rohit29d/silent-speech-controlled-wheelchair-using-sEMG-signals-from-the-laryngeal-region/hardware/afe/AFE_Breadboard.jpg

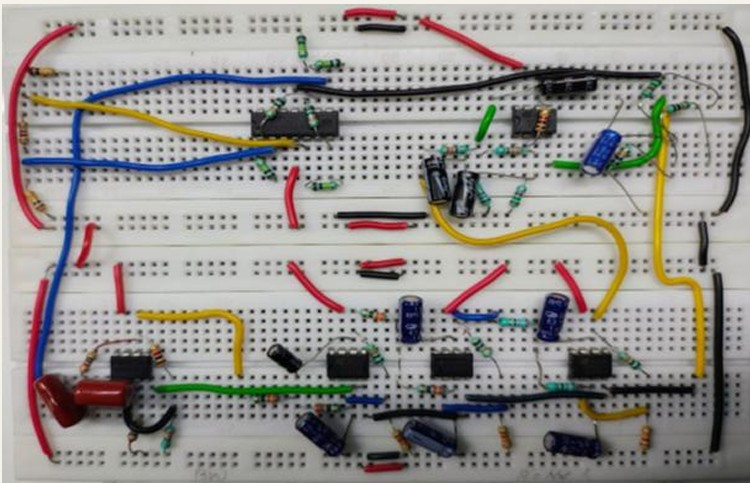
hardware/afe/AFE_Breadboard.jpg
