rohit29d/silent-speech-controlled-wheelchair-using-sEMG-signals-from-the-laryngeal-region/hardware/afe/sEMG_AFE_V2.1.kicad_pro/output/sEMG_AFE_V2.1.kicad_pro_BOM.csv

ITEM_NUMBER | Reference | Value | Footprint | Description | QUANTITY | DNP | MPN | SKU | Link
1 | C1,C2,C3,C4,C5,C6,C7,C8,C9,C10 | 1u | Capacitor_SMD:C_0805_2012Metric | Unpolarized capacitor | 10
2 | C11 | 2.2u | Capacitor_SMD:C_0805_2012Metric | Unpolarized capacitor | 1
3 | C12,C13,C14,C15,C16,C17,C18,C19,C20,C21,C22,C23 | 100nF | Capacitor_SMD:C_0805_2012Metric | Unpolarized capacitor | 12
4 | J1 | Conn_01x03_Pin | Connector_JST:JST_EH_B3B-EH-A_1x03_P2.50mm_Vertical | Generic connector, single row, 01x03, script generated | 1
5 | J2 | Conn_01x01_Pin | Connector_JST:JST_EH_B2B-EH-A_1x02_P2.50mm_Vertical | Generic connector, single row, 01x02, script generated | 1
6 | J3 | Conn_01x04_Pin | TerminalBlock:TerminalBlock_Xinya_XY308-2.54-4P_1x04_P2.54mm_Horizontal | Generic connector, single row, 01x04, script generated | 1
7 | JP1,JP2,JP3 | Jumper_2_Bridged | Connector_PinHeader_2.54mm:PinHeader_1x02_P2.54mm_Vertical | Jumper, 2-pole, closed/bridged | 3
8 | R1,R5,R14,R18,R22 | 10k | Resistor_SMD:R_0805_2012Metric | Resistor | 5
9 | R2,R4,R6,R7 | 100k | Resistor_SMD:R_0805_2012Metric | Resistor | 4
10 | R8,R28 | 1k | Resistor_SMD:R_0805_2012Metric | Resistor | 2
11 | R9,R10 | 6.8k | Resistor_SMD:R_0805_2012Metric | Resistor | 2
12 | R11,R24,R25 | 3.3k | Resistor_SMD:R_0805_2012Metric | Resistor | 3
13 | R12,R13,R16,R17 | 330 | Resistor_SMD:R_0805_2012Metric | Resistor | 4
14 | R15,R19,R23 | 20k | Resistor_SMD:R_0805_2012Metric | Resistor | 3
15 | R20,R21 | 270 | Resistor_SMD:R_0805_2012Metric | Resistor | 2
16 | R26 | 1.2k | Resistor_SMD:R_0805_2012Metric | Resistor | 1
17 | R27 | 1.5k | Resistor_SMD:R_0805_2012Metric | Resistor | 1
18 | Rg1 | R_Potentiometer_Trim | Potentiometer_SMD:Potentiometer_Bourns_3314G_Vertical | Trim-potentiometer | 1
19 | U1,U2,U3,U4,U5 | LM741 | Package_SO:JEITA_SOIC-8_3.9x4.9mm_P1.27mm | Operational Amplifier, DIP-8/TO-99-8 | 5
20 | U6 | LM324NSRE4 | LM324_SMD:SOIC127P780X200-14N |  | 1
