rohit29d/silent-speech-controlled-wheelchair-using-sEMG-signals-from-the-laryngeal-region/hardware/simulations/bessel_bpf_4.pdf

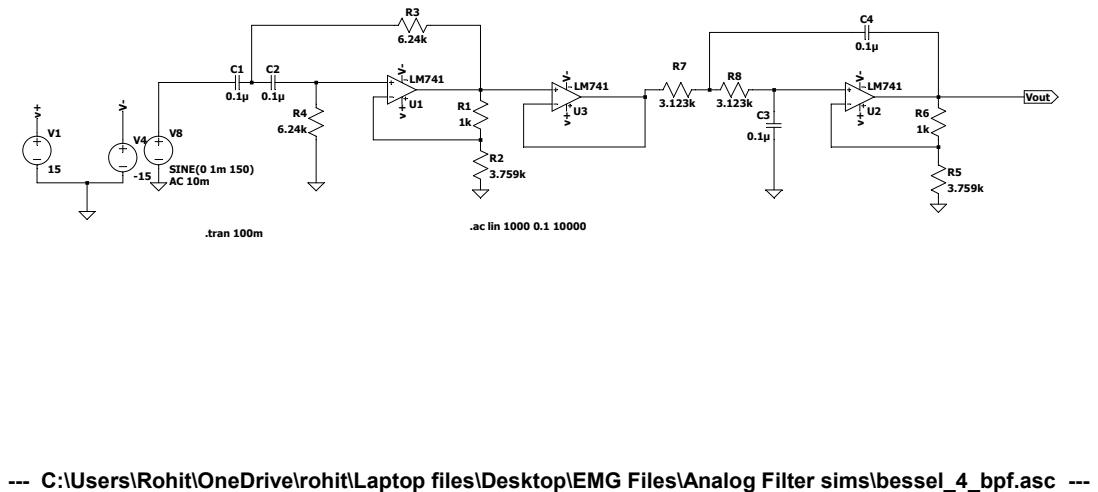
[picture p12: page 1]

--- C:\Users\Rohit\OneDrive\rohit\Laptop files\Desktop\EMG Files\Analog Filter sims\bessel_4_bpf.asc ---
