rohit29d/silent-speech-controlled-wheelchair-using-sEMG-signals-from-the-laryngeal-region/hardware/simulations/bessel_bpf_4_freq_resp.pdf

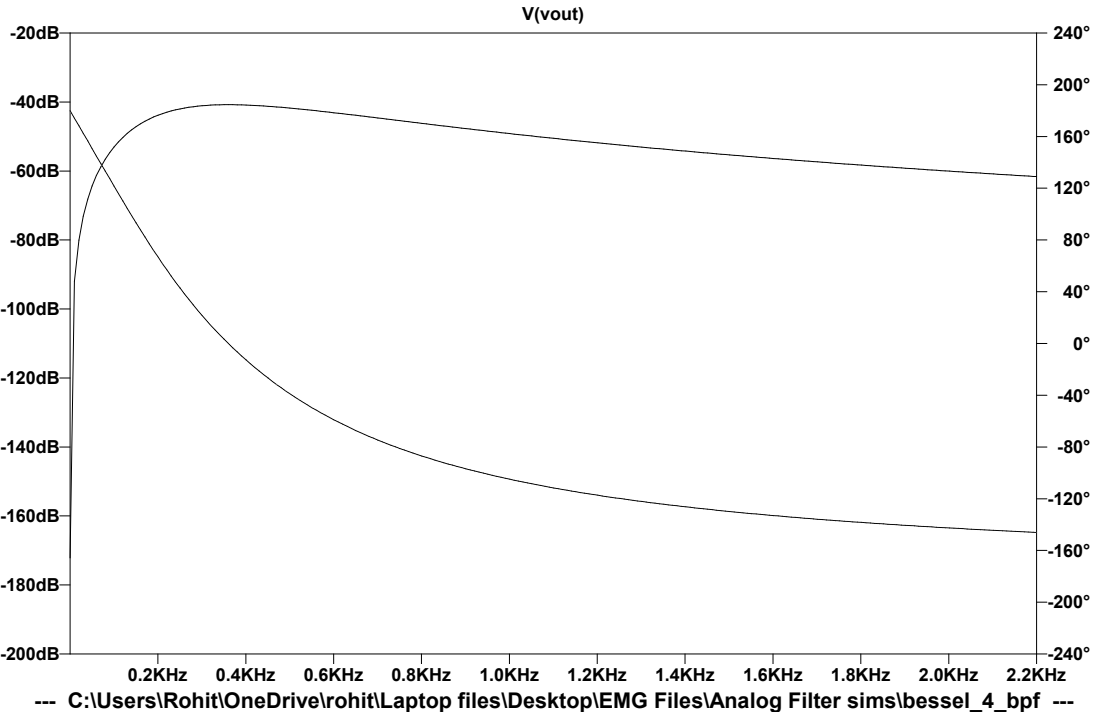
[picture p13: page 1]
0.2KHz; 0.4KHz; 0.6KHz; 0.8KHz; 1.0KHz; 1.2KHz; 1.4KHz; 1.6KHz; 1.8KHz; 2.0KHz; 2.2KHz; V(vout)

--- C:\Users\Rohit\OneDrive\rohit\Laptop files\Desktop\EMG Files\Analog Filter sims\bessel_4_bpf ---
