rohit29d/silent-speech-controlled-wheelchair-using-sEMG-signals-from-the-laryngeal-region/hardware/afe/sEMG_AFE_V2.1.kicad_pro/output/sEMG_AFE_V2.1.kicad_pro_schematic.pdf

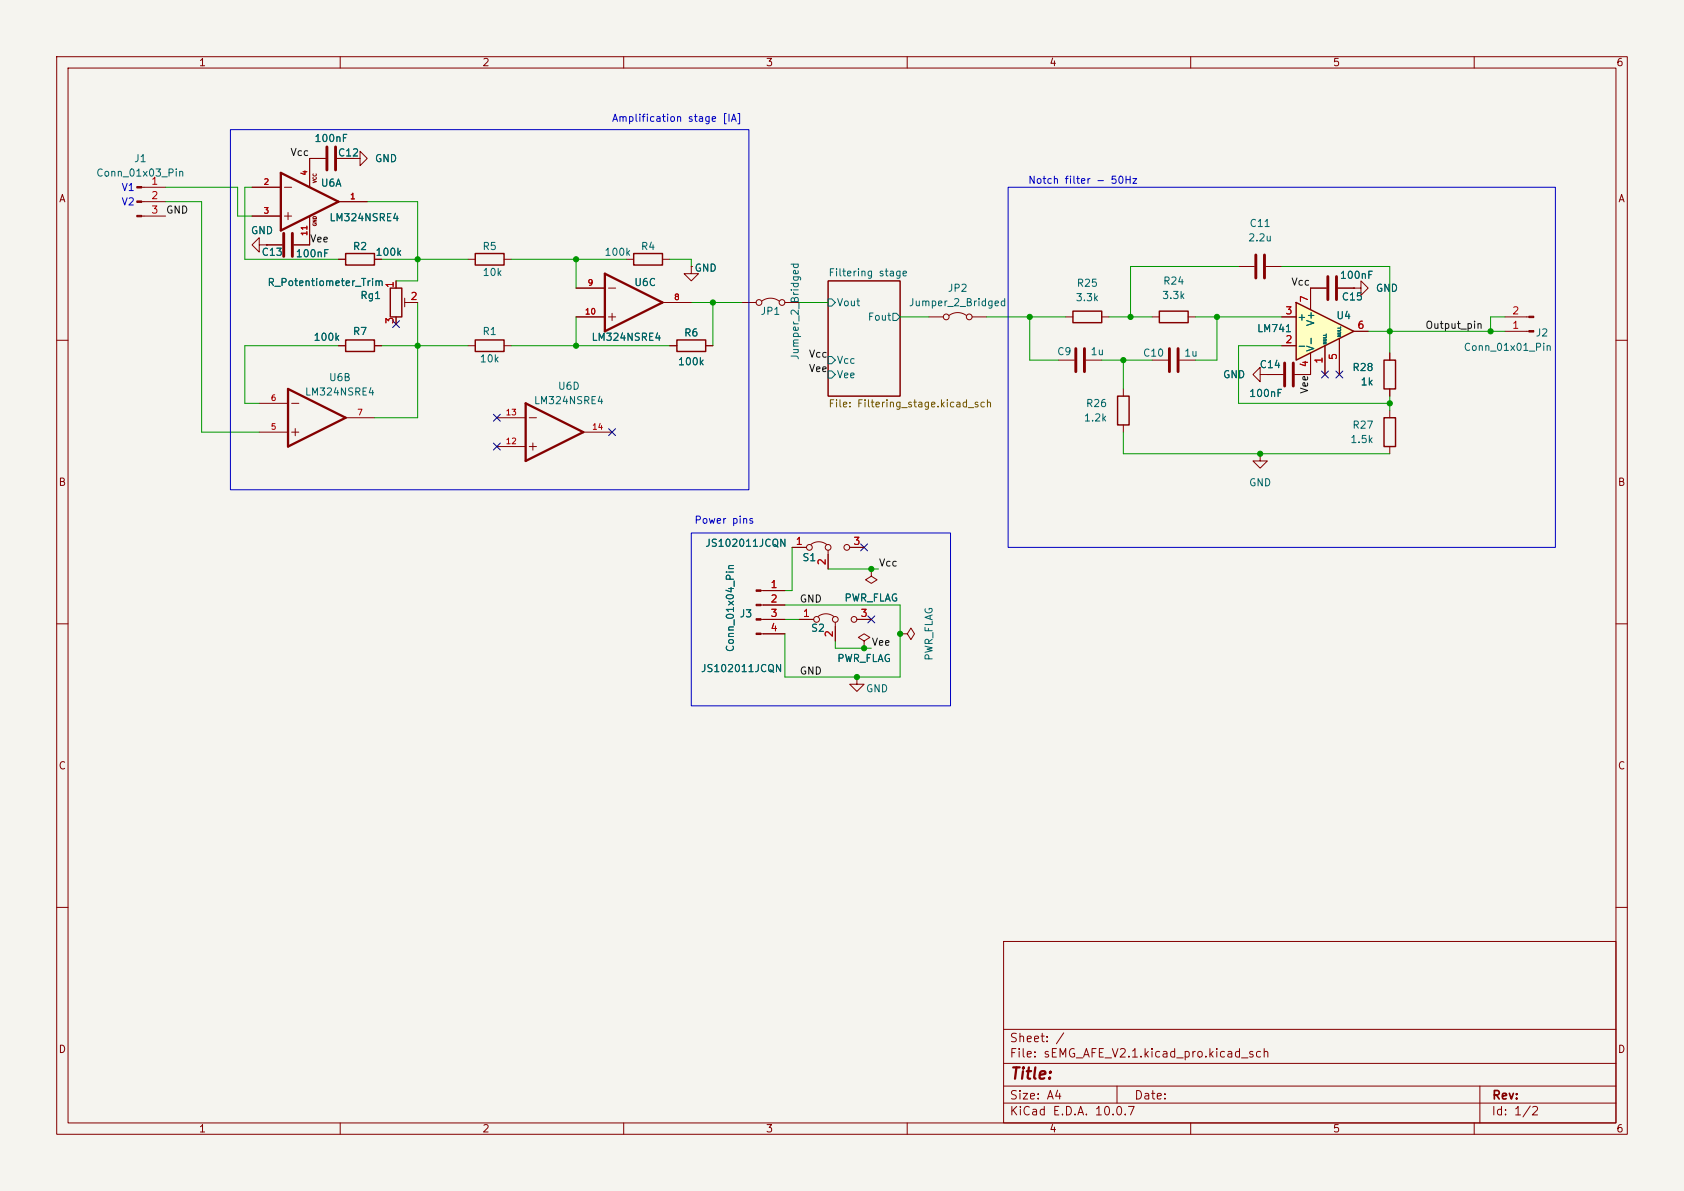
[picture p14: page 1]

Vout Fout Filtering stage

Size: A4 | Rev:
KiCad E.D.A. 10.0.7 | Id: 1/2

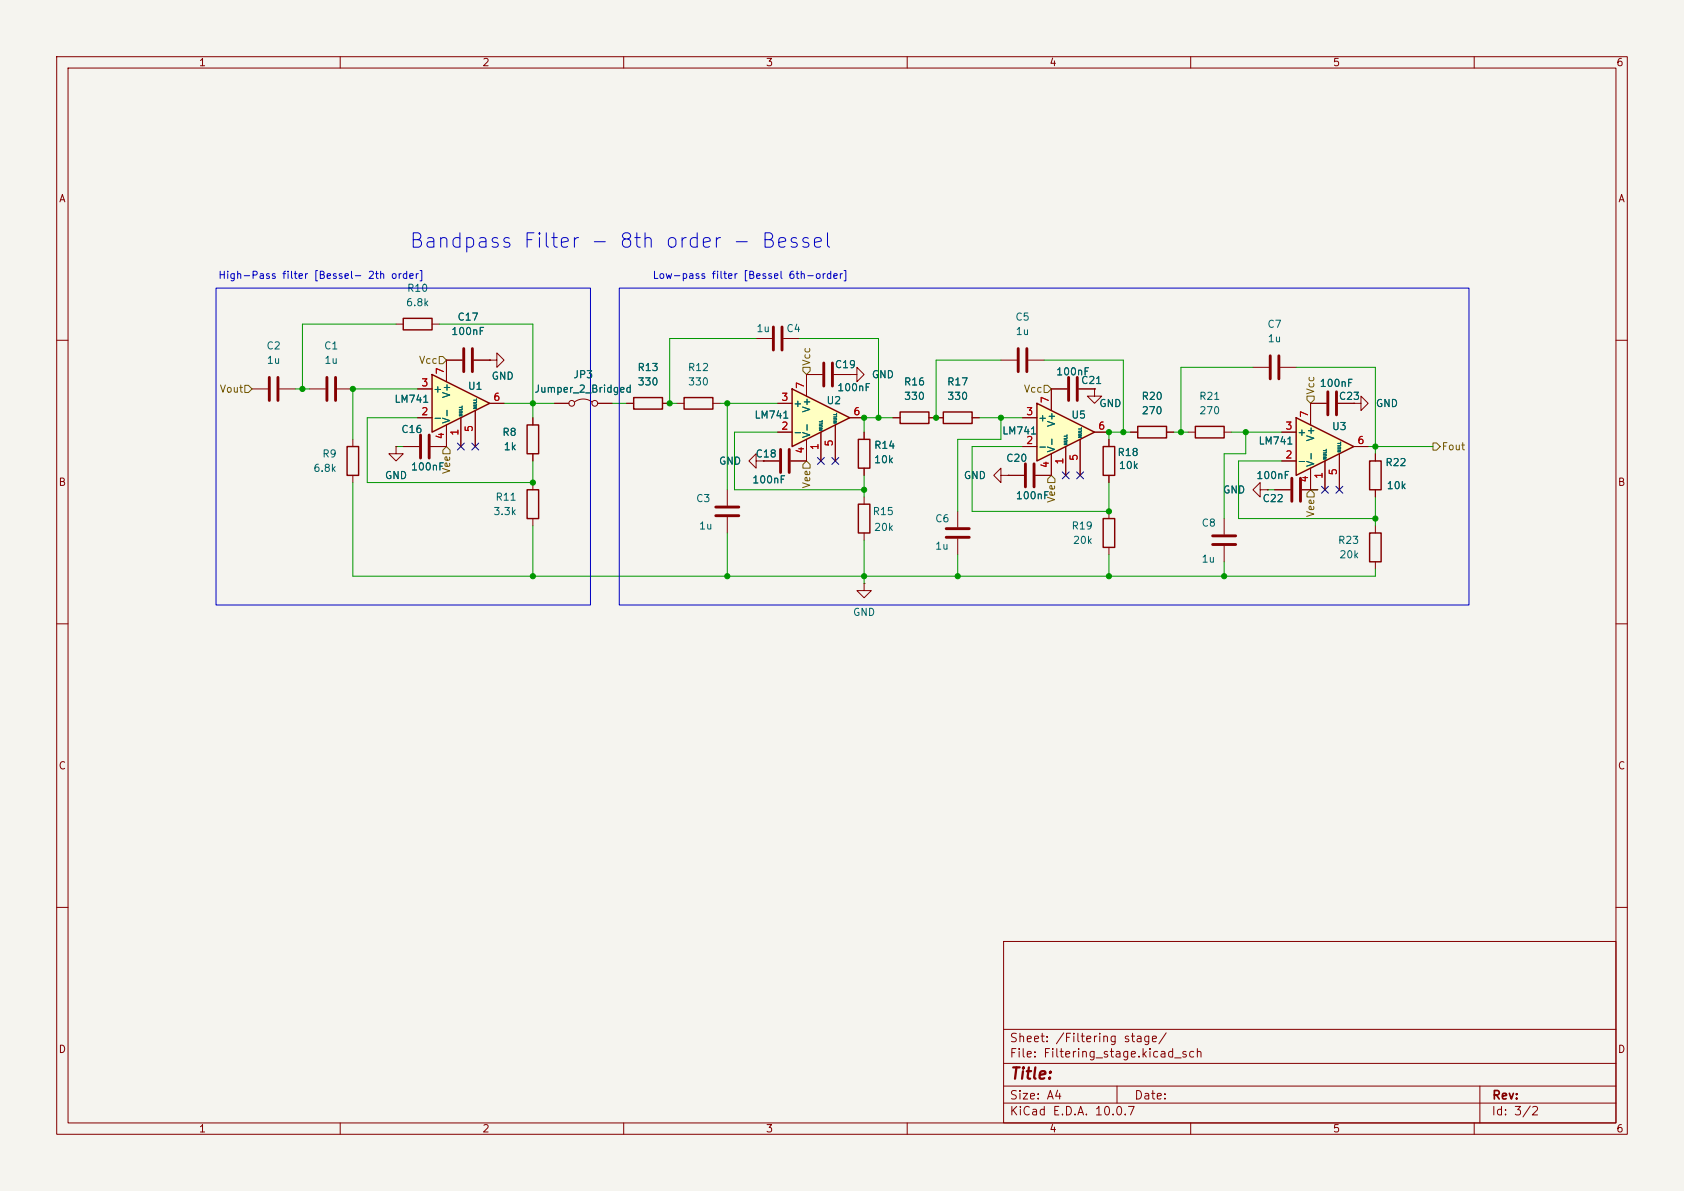
[picture p15: page 2]

Bandpass Filter - 8th order - Bessel

Size: A4 | Rev:
KiCad E.D.A. 10.0.7 | Id: 3/2
