rohit29d/silent-speech-controlled-wheelchair-using-sEMG-signals-from-the-laryngeal-region/hardware/afe/sEMG_AFE_V2.1.kicad_pro/output/sEMG_AFE_V2.1.kicad_pro_Bottom_Assembly.pdf

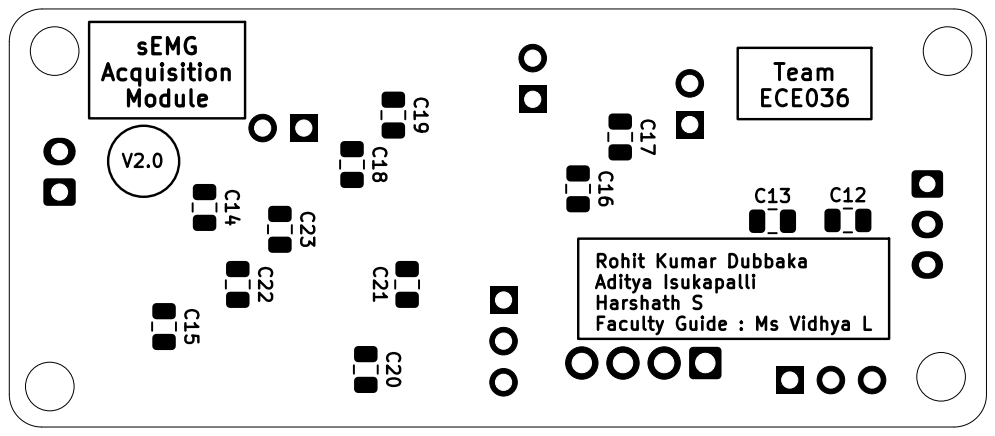
[picture p16: page 1]

Faculty Guide : Ms Vidhya L Team
