rohit29d/silent-speech-controlled-wheelchair-using-sEMG-signals-from-the-laryngeal-region/hardware/afe/sEMG_AFE_V2.1.kicad_pro/output/sEMG_AFE_V2.1.kicad_pro_Top_Assembly.pdf

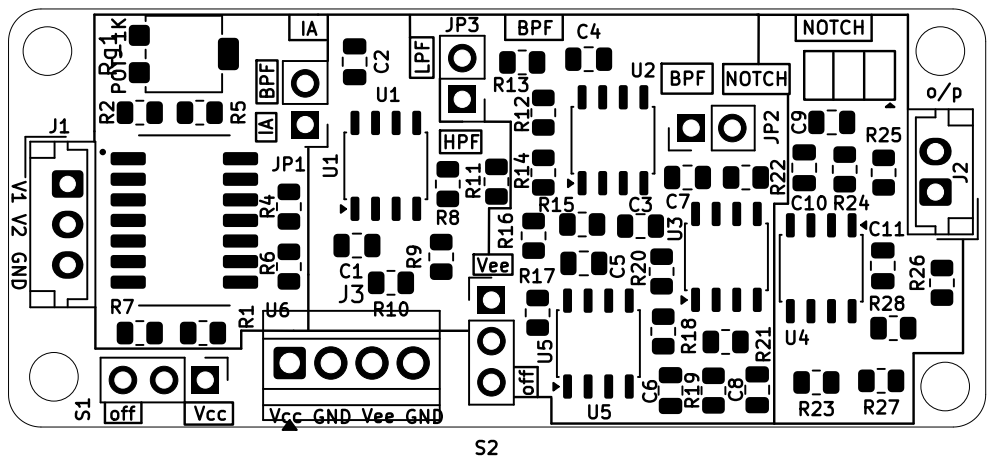
[picture p17: page 1]
