rohit29d/silent-speech-controlled-wheelchair-using-sEMG-signals-from-the-laryngeal-region/hardware/simulations/bessel_final_4th_order_bpf.asc

C1: cap; 0.1µ
C2: cap; 0.1µ
C3: cap; 0.1µ
C4: cap; 0.1µ
R1: res; 62k
R2: res; 1k
R3: res; 3.759k
R4: res; 3.123k
R5: res; 1k
R6: res; 3.759k
R7: res; 3.123k
R10: res; 62k
U1: opamp2; UA741
U2: opamp2; UA741
V1: voltage; 15
V2: voltage; 15
V3: voltage; SINE(0 1m 150); AC AC 1
Named nets: 0, V+, V-, Vin
.include UA741.301
;tran 11s
.ac lin 1000 1 20k
