rohit29d/silent-speech-controlled-wheelchair-using-sEMG-signals-from-the-laryngeal-region/hardware/simulations/Butterworth_filter.asc

C1: cap; 1µ
C2: cap; 1µ
C5: cap; 0.1µ
C6: cap; 0.1µ
R1: res; 0.58k
R2: res; 1k
R3: res; 7.95k
R4: res; 7.95k
R9: res; 0.58k
R10: res; 1k
R11: res; 5.30k
R12: res; 5.30k
U1: opamp2; TL084
U3: opamp2; TL084
V1: voltage; 12
V2: voltage; 12
V7: voltage; 12
V8: voltage; 12
V9: voltage; PWL file="C:\Users\SPR\OneDrive\Pictures\Documents\3rd year (6)\emg_input_ltspice_1.txt"; AC 1
Named nets: 0, Vo
.include "C:\\Users\\SPR\\Downloads\\sloj071\\TL084.301"
.meas RMS_filtered_signal RMS V(Vo) FROM 0 to 10ms
.meas RMS_filtered_signal RMS V(emg_input_ltspice_1) FROM 0 to 10ms
.ac lin 0.01 10 1k
