rohit29d/silent-speech-controlled-wheelchair-using-sEMG-signals-from-the-laryngeal-region/hardware/simulations/intrs_amp.asc

R1: res; 50k
R2: res; 50k
R3: res; 25k
R4: res; 25k
R5: res; 25k
R6: res; 25k
R7: res; 50
R8: res; 100k
R9: res; 10k
R10: res; 100k
U1: LM741
U2: LM741
U3: LM741
V1: voltage; SINE(0 1 150)
V3: voltage; 15
V4: voltage; 15
Named nets: 0, V+, V-, Vout
.tran 100m
