rohit29d/silent-speech-controlled-wheelchair-using-sEMG-signals-from-the-laryngeal-region/hardware/simulations/Notch.asc

C1: cap; 1µ
C2: cap; 1µ
R1: res; 3.2k
R2: res; 3.2k
R3: res; 3.2k
R4: res; 3.2k
U2: LM741
V1: voltage; 15
V2: voltage; 15
V3: voltage; SINE(0 1m 150); AC 1
Named nets: 0, Vo
.tran 0.01
.ac dec 10 1 100
