rohit29d/silent-speech-controlled-wheelchair-using-sEMG-signals-from-the-laryngeal-region/hardware/afe/sEMG_AFE_V2.1.kicad_pro/sEMG_AFE_V2.1.kicad_pro.kicad_pcb

## KiCad design hardware/afe/sEMG_AFE_V2.1.kicad_pro/sEMG_AFE_V2.1.kicad_pro.kicad_pcb (2026-10-13)

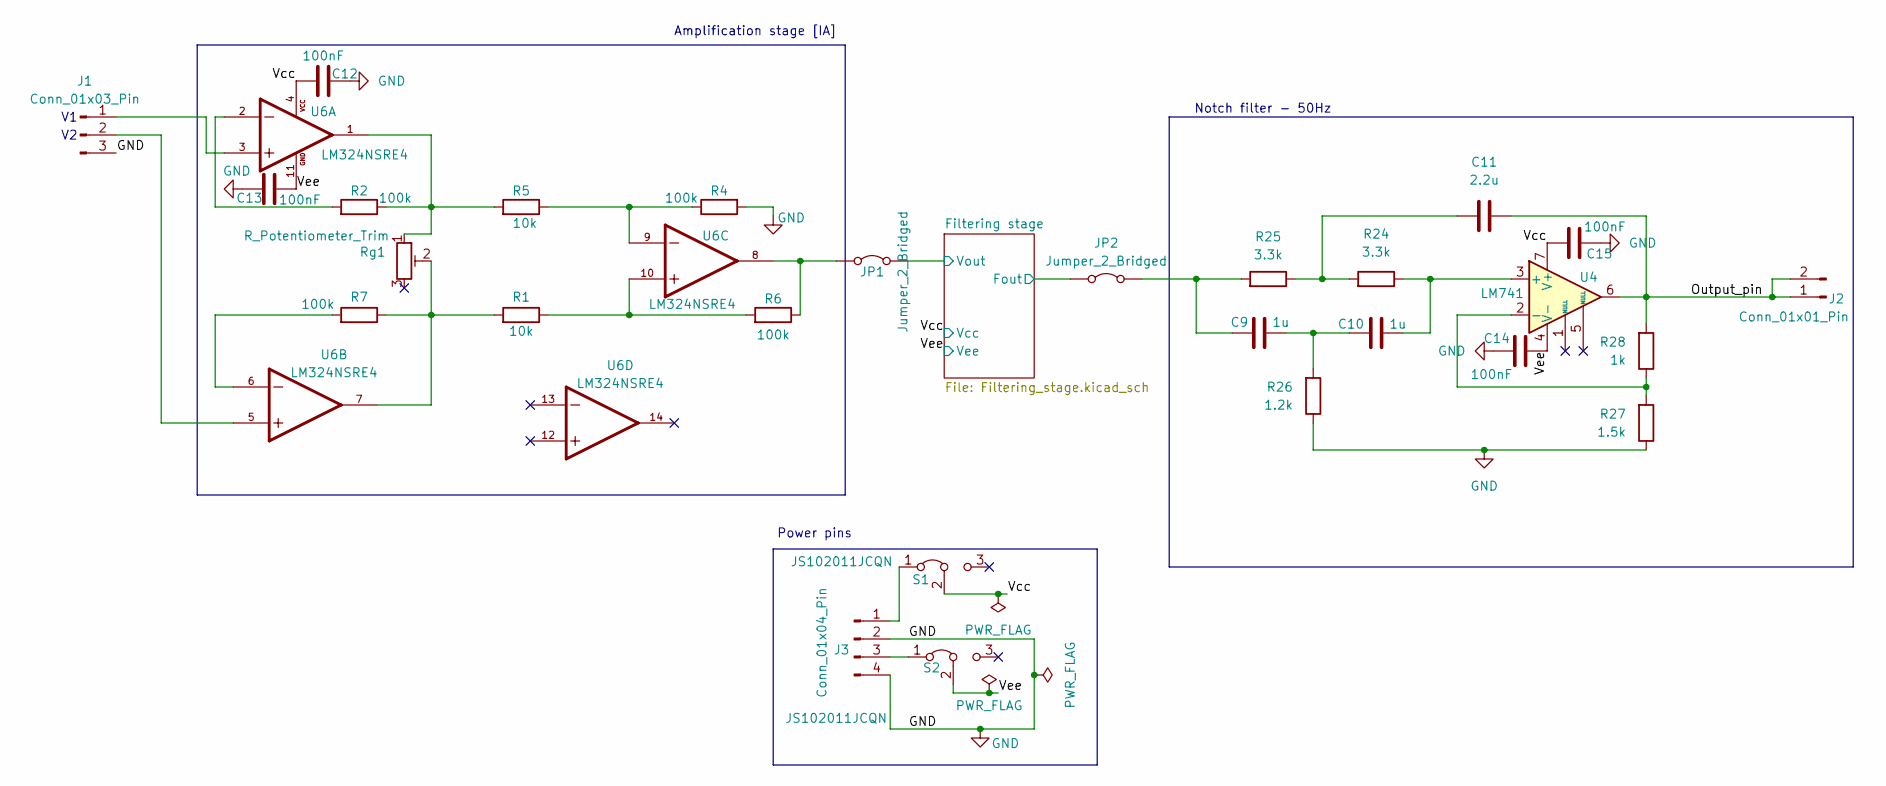
[picture p18: schematic sEMG_AFE_V2.1.kicad_pro.kicad_sch]

Parts:
C9, C10: 1u; C_0805_2012Metric
C11: 2.2u; C_0805_2012Metric
C12, C13, C14, C15: 100nF; C_0805_2012Metric
J1: Conn_01x03_Pin; JST_EH_B3B-EH-A_1x03_P2.50mm_Vertical
J2: Conn_01x01_Pin; JST_EH_B2B-EH-A_1x02_P2.50mm_Vertical
J3: Conn_01x04_Pin; TerminalBlock_Xinya_XY308-2.54-4P_1x04_P2.54mm_Horizontal
JP1, JP2: Jumper_2_Bridged; PinHeader_1x02_P2.54mm_Vertical
R1, R5: 10k; R_0805_2012Metric
R2, R4, R6, R7: 100k; R_0805_2012Metric
R24, R25: 3.3k; R_0805_2012Metric
R26: 1.2k; R_0805_2012Metric
R27: 1.5k; R_0805_2012Metric
R28: 1k; R_0805_2012Metric
Rg1: R_Potentiometer_Trim; Potentiometer_Bourns_3314G_Vertical
S1, S2: JS102011JCQN; PinHeader_1x03_P2.54mm_Vertical; PARTREV 29 JUN 2016
U4: LM741; JEITA_SOIC-8_3.9x4.9mm_P1.27mm
U6: LM324NSRE4; SOIC127P780X200-14N; PARTREV W

Connections:
/Filtering stage/Fout: JP2.1 (A); also elsewhere on the board
/Filtering stage/Vout: JP1.2 (B); also elsewhere on the board
/Output_pin: C11.2, J2.1, J2.2, R28.2, U4.6
/Vcc: C12.1, C15.1, S1.2 (C), U4.7 (V+), U6.4; also elsewhere on the board
/Vee: C13.2, C14.2, S2.2 (C), U4.4 (V-), U6.11; also elsewhere on the board
GND: C12.2, C13.1, C14.1, C15.2, J1.3, J3.2, J3.4, R4.2, R26.1, R27.1; also elsewhere on the board
unnamed: C9.2, C10.1, R26.2
unnamed: C11.1, R24.2, R25.1
unnamed: J1.1, U6.3
unnamed: J1.2, U6.5
unnamed: J3.1, S1.1 (A)
unnamed: J3.3, S2.1 (A)
unnamed: JP1.1 (A), R6.1, U6.8
unnamed: C9.1, JP2.2 (B), R25.2
unnamed: R1.1, R6.2, U6.10
unnamed: R1.2, R7.1, Rg1.2, U6.7
unnamed: R2.1, R5.2, Rg1.1, U6.1
unnamed: R2.2, U6.2
unnamed: R4.1, R5.1, U6.9
unnamed: R7.2, U6.6
unnamed: C10.2, R24.1, U4.3 (+)
unnamed: R27.2, R28.1, U4.2 (-)

Notes on the sheet:
Amplification stage [IA]
Power pins
Notch filter - 50Hz

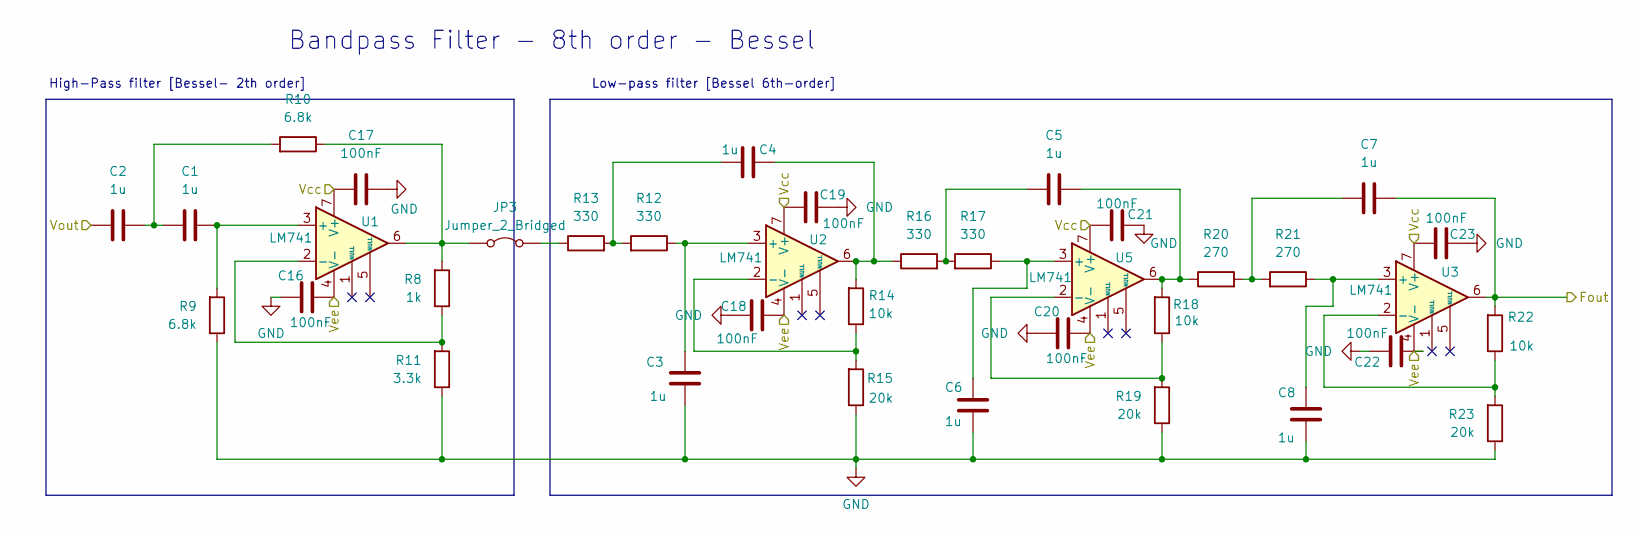
[picture p19: schematic Filtering_stage.kicad_sch]

Parts:
C1, C2, C3, C4, C5, C6, C7, C8: 1u; C_0805_2012Metric
C16, C17, C18, C19, C20, C21, C22, C23: 100nF; C_0805_2012Metric
JP3: Jumper_2_Bridged; PinHeader_1x02_P2.54mm_Vertical
R8: 1k; R_0805_2012Metric
R9, R10: 6.8k; R_0805_2012Metric
R11: 3.3k; R_0805_2012Metric
R12, R13, R16, R17: 330; R_0805_2012Metric
R14, R18, R22: 10k; R_0805_2012Metric
R15, R19, R23: 20k; R_0805_2012Metric
R20, R21: 270; R_0805_2012Metric
U1, U2, U3, U5: LM741; JEITA_SOIC-8_3.9x4.9mm_P1.27mm

Connections:
/Filtering stage/Fout: C7.2, R22.2, U3.6; also elsewhere on the board
/Filtering stage/Vout: C2.1; also elsewhere on the board
/Vcc: C17.1, C19.1, C21.1, C23.1, U1.7 (V+), U2.7 (V+), U3.7 (V+), U5.7 (V+); also elsewhere on the board
/Vee: C16.2, C18.2, C20.2, C22.2, U1.4 (V-), U2.4 (V-), U3.4 (V-), U5.4 (V-); also elsewhere on the board
GND: C3.1, C6.1, C8.1, C16.1, C17.2, C18.1, C19.2, C20.1, C21.2, C22.1, C23.2, R9.1, R11.1, R15.1, R19.1, R23.1; also elsewhere on the board
unnamed: C1.1, C2.2, R10.2
unnamed: C4.1, R12.2, R13.2
unnamed: C4.2, R14.2, R16.1, U2.6
unnamed: C5.1, R16.2, R17.2
unnamed: C5.2, R18.2, R20.1, U5.6
unnamed: C7.1, R20.2, R21.2
unnamed: JP3.1 (A), R8.2, R10.1, U1.6
unnamed: JP3.2 (B), R13.1
unnamed: C1.2, R9.2, U1.3 (+)
unnamed: R8.1, R11.2, U1.2 (-)
unnamed: C3.2, R12.1, U2.3 (+)
unnamed: R14.1, R15.2, U2.2 (-)
unnamed: C8.2, R21.1, U3.3 (+)
unnamed: R22.1, R23.2, U3.2 (-)
unnamed: C6.2, R17.1, U5.3 (+)
unnamed: R18.1, R19.2, U5.2 (-)

Notes on the sheet:
Low-pass filter [Bessel 6th-order]
Bandpass Filter - 8th order - Bessel
High-Pass filter [Bessel- 2th order]

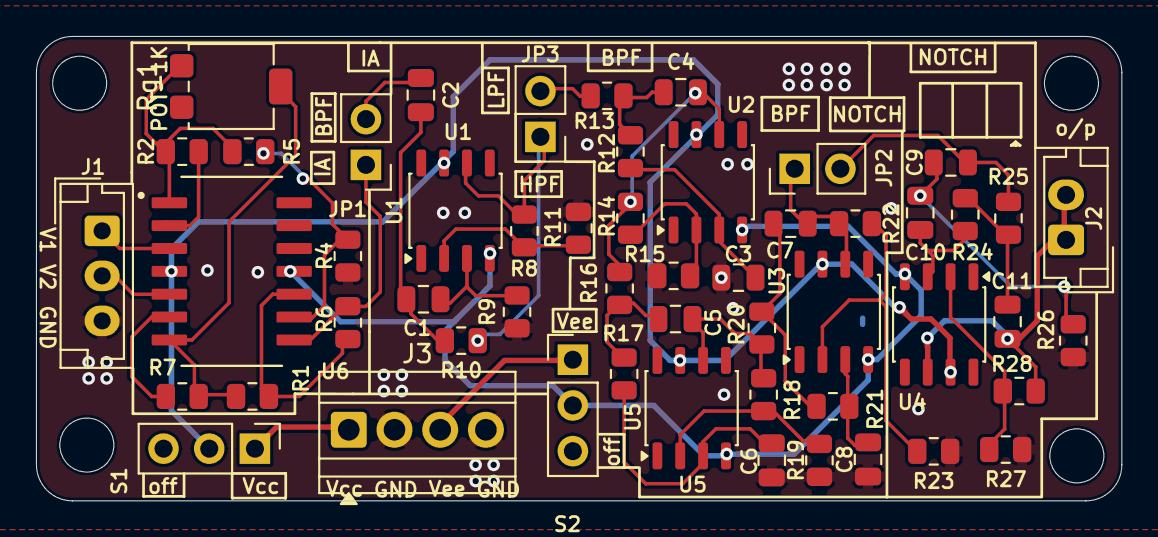
[picture p20: board sEMG_AFE_V2.1.kicad_pro.kicad_pcb from above]

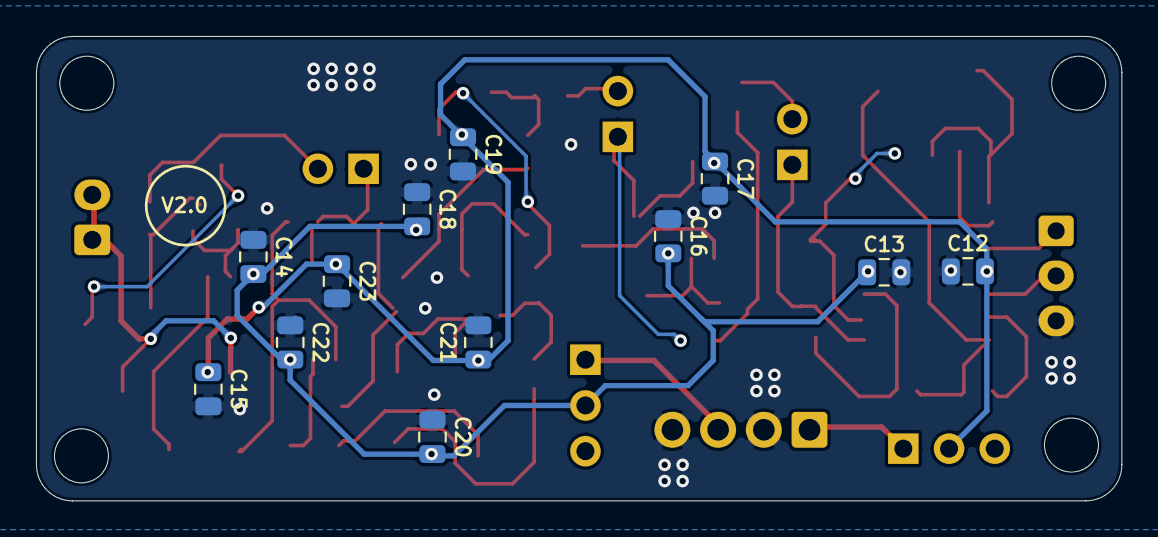
[picture p21: board sEMG_AFE_V2.1.kicad_pro.kicad_pcb from below]

Board: 2 copper layers, 60.3 x 25.8 mm, 65 parts (12 on the bottom side), 38 nets.
