rohit29d/silent-speech-controlled-wheelchair-using-sEMG-signals-from-the-laryngeal-region/firmware/stm32h7_controller/model_testing/model_testing.ioc

Mcu.UserName=STM32H753ZITx
PB0.Signal=GPIO_Output
PB14.Signal=GPIO_Output
PB7.Signal=GPIO_Output
PC10.GPIO_Label=trig_back_pin
PC10.Signal=GPIO_Output
PC11.GPIO_Label=echo_back_pin
PC11.Signal=GPIO_Input
PC13.Signal=GPIO_Input
PD8.Signal=USART3_TX
PD9.Signal=USART3_RX
PE10.GPIO_Label=REN_L
PE10.Signal=GPIO_Output
PE11.Signal=S_TIM1_CH2
PE12.GPIO_Label=LEN_L
PE12.Signal=GPIO_Output
PE13.Signal=S_TIM1_CH3
PE14.Signal=S_TIM1_CH4
PE5.GPIO_Label=trig_front_pin
PE5.Signal=GPIO_Output
PE6.GPIO_Label=echo_front_pin
PE6.Signal=GPIO_Input
PE7.GPIO_Label=REN_R
PE7.Signal=GPIO_Output
PE8.GPIO_Label=LEN_R
PE8.Signal=GPIO_Output
PE9.Signal=S_TIM1_CH1
