rohit29d/silent-speech-controlled-wheelchair-using-sEMG-signals-from-the-laryngeal-region/firmware/stm32h7_controller/model_testing/Core/Inc/main.h

#define trig_front_pin_Pin GPIO_PIN_5
#define trig_front_pin_GPIO_Port GPIOE
#define echo_front_pin_Pin GPIO_PIN_6
#define echo_front_pin_GPIO_Port GPIOE
#define REN_R_Pin GPIO_PIN_7
#define REN_R_GPIO_Port GPIOE
#define LEN_R_Pin GPIO_PIN_8
#define LEN_R_GPIO_Port GPIOE
#define REN_L_Pin GPIO_PIN_10
#define REN_L_GPIO_Port GPIOE
#define LEN_L_Pin GPIO_PIN_12
#define LEN_L_GPIO_Port GPIOE
#define trig_back_pin_Pin GPIO_PIN_10
#define trig_back_pin_GPIO_Port GPIOC
#define echo_back_pin_Pin GPIO_PIN_11
#define echo_back_pin_GPIO_Port GPIOC
