rohit29d/silent-speech-controlled-wheelchair-using-sEMG-signals-from-the-laryngeal-region/(commit log)

2026-10-13 refactor: complete sEMG silent-speech assistive wheelchair monorepo
    [BOM.csv, Filtering_stage.kicad_sch, instrumentation_amplifier.kicad_sch, master_training_features.csv, s48_Analog - 08-10-2025 11-45-25.1520.csv, s48_Analog - 08-10-2025 11-45-29.5548.csv, s48_Analog - 08-10-2025 11-45-32.8902.csv, s48_Analog - 08-10-2025 11-45-36.4270.csv]
2026-10-13 readme update
    [BOM.csv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]
2026-10-14 EOD update
    [master_training_features.csv, s48_Analog - 08-10-2025 11-45-25.1520.csv, s48_Analog - 08-10-2025 11-45-29.5548.csv, s48_Analog - 08-10-2025 11-45-32.8902.csv, s48_Analog - 08-10-2025 11-45-36.4270.csv, s48_Analog - 08-10-2025 11-45-40.8840.csv, s48_Analog - 08-10-2025 11-45-57.3499.csv, s48_Analog - 08-10-2025 11-46-00.6897.csv]
